RyAlaan/krai-2026/Base_STM32/LowerPart.h

#ifndef LOWERPART_H
#define LOWERPART_H

#include "Motor.h"

class LowerPart {
  private:
    Motor roda_1;
    Motor roda_2;
    Motor roda_3;
    Motor roda_4;

  public:
    LowerPart();   // dummy (pin 0,0)
    LowerPart(byte sel_1, byte pwm_1,
              byte sel_2, byte pwm_2,
              byte sel_3, byte pwm_3,
              byte sel_4, byte pwm_4);

    void Movement(float V1, float V2, float V3, float V4);  // nilai −4095…+4095
};

#endif
