RyAlaan/krai-2026/(commit log)

2026-02-27 add IMU and PID
2026-02-27 add imu
2026-04-09 add imu esp
